DavidMFlynn/Rocket-Servo/README.md

# Rocket-Servo
 Altimeter triggered 2 position servo driver
