DavidMFlynn/Rocket-Servo/PCB RS2 Rev nc/Fixture/Fixture.3mf

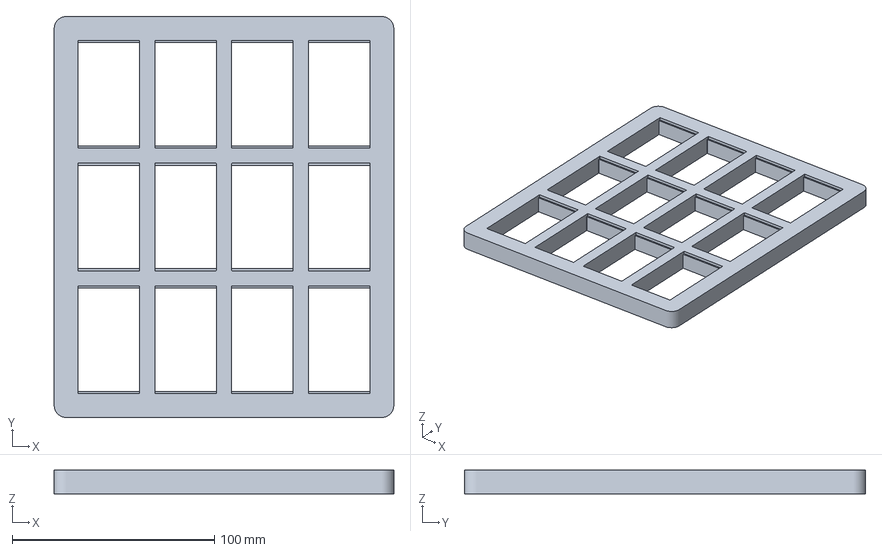
[picture p1: CAD file, 2025-12-25]
PCB RS2 Rev nc/Fixture/Fixture.3mf
168.0 x 198.4 x 11.7 mm
