DavidMFlynn/Rocket-Servo/RS2_PCBA_Fixture.3mf

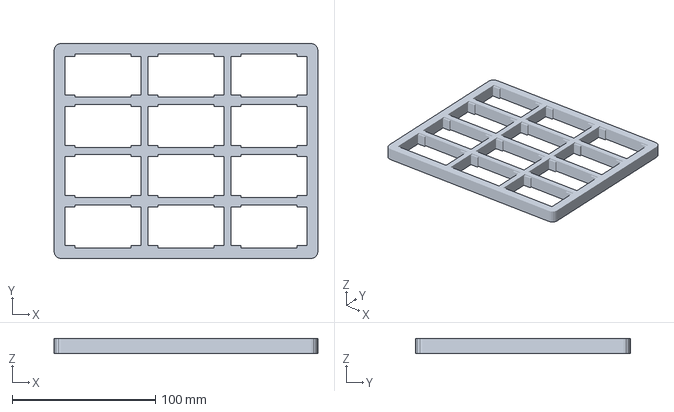
[picture p2: CAD file, 2026-05-11]
RS2_PCBA_Fixture.3mf
184.0 x 150.0 x 10.5 mm
