DavidMFlynn/Rocket-Servo/RS_PCBA_Fixture.3mf

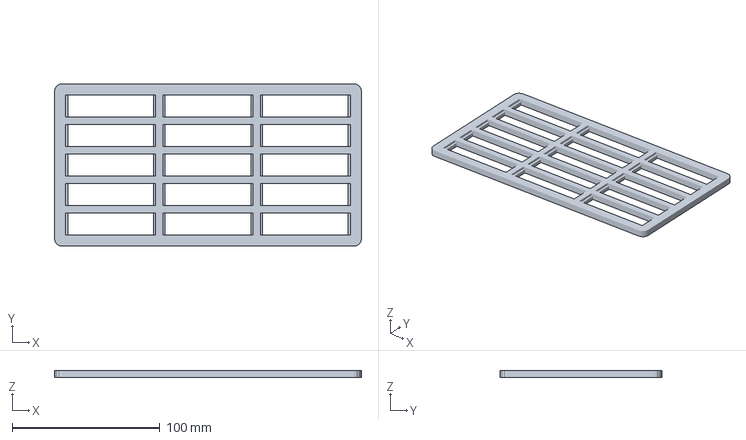
[picture p3: CAD file, 2024-05-13]
RS_PCBA_Fixture.3mf
208.0 x 110.0 x 5.00 mm
