DavidMFlynn/Rocket-Servo/(list of files, cad)

Other CAD files:
PCB RS2 Rev nc/Fixture/Fixture.stl
RS2_PCBA_Fixture.stl
RS_PCBA_Fixture.stl
