DavidMFlynn/Rocket-Servo/PCB Rev C/RocketServo.sch.pdf

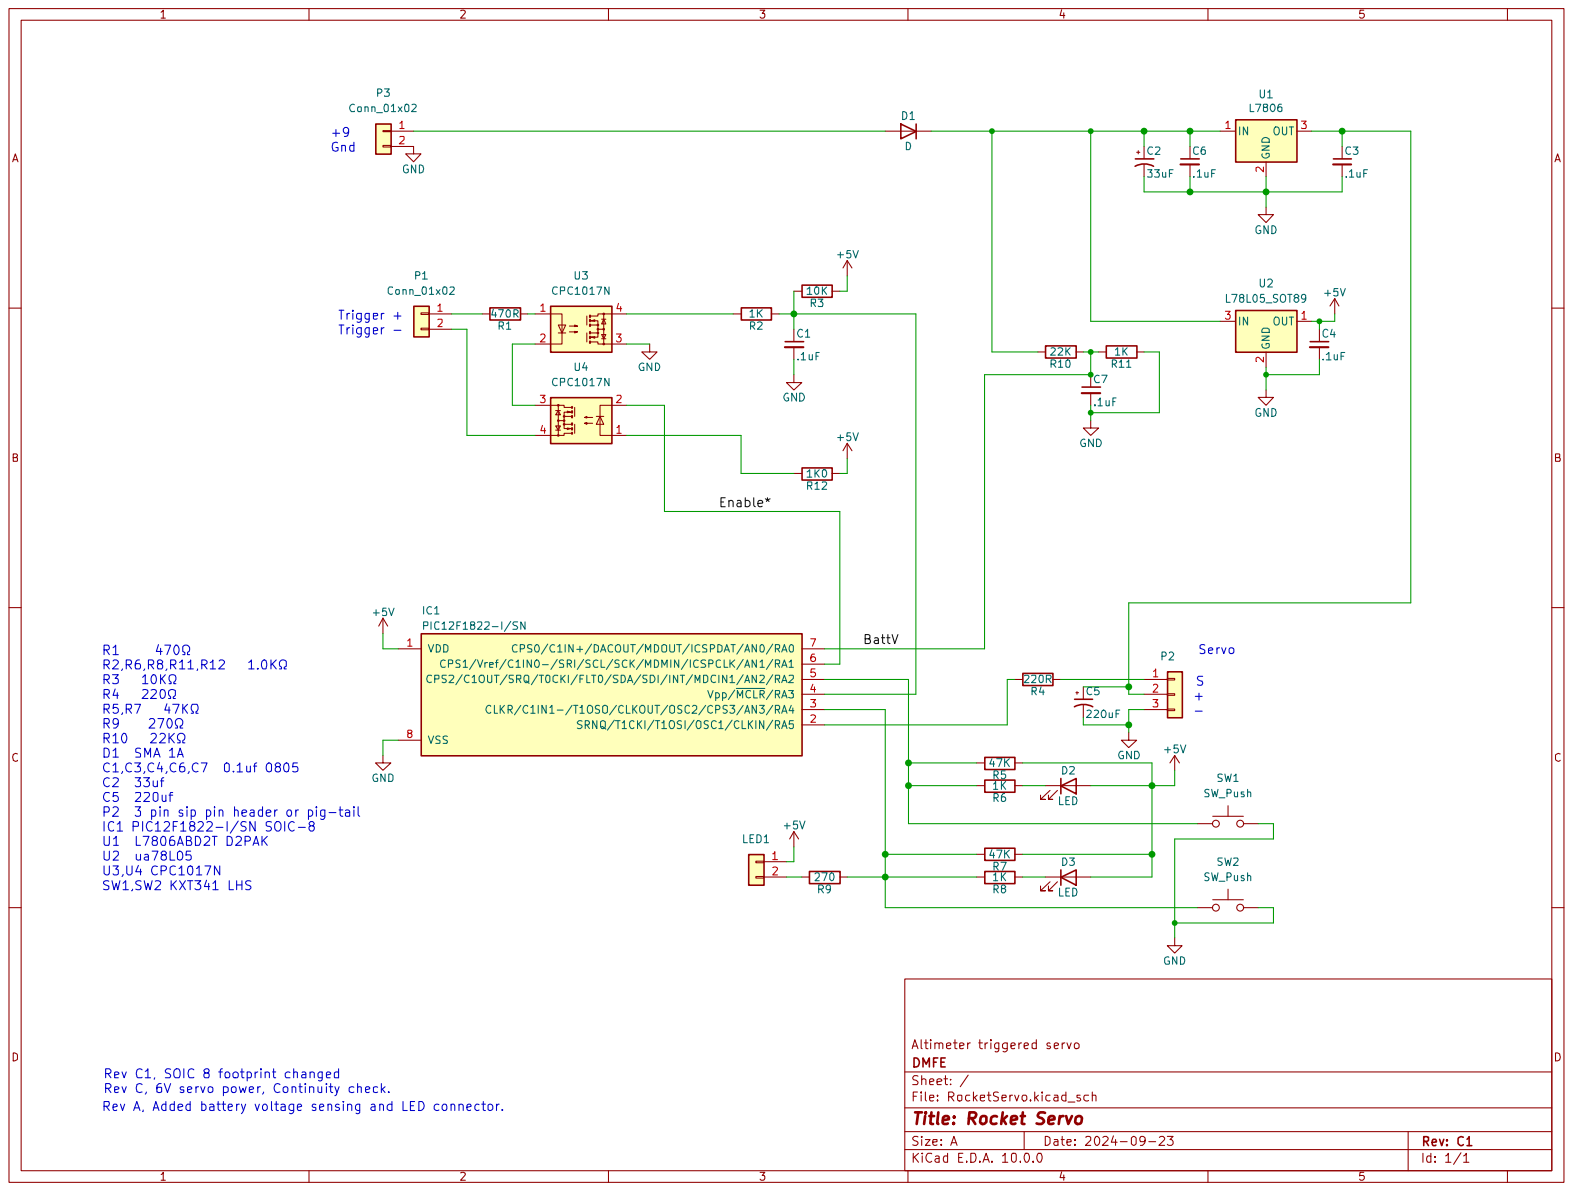
[picture p4: page 1]
