DavidMFlynn/Rocket-Servo/PCB RS2 Rev nc/RocketServo.kicad_sch.pdf

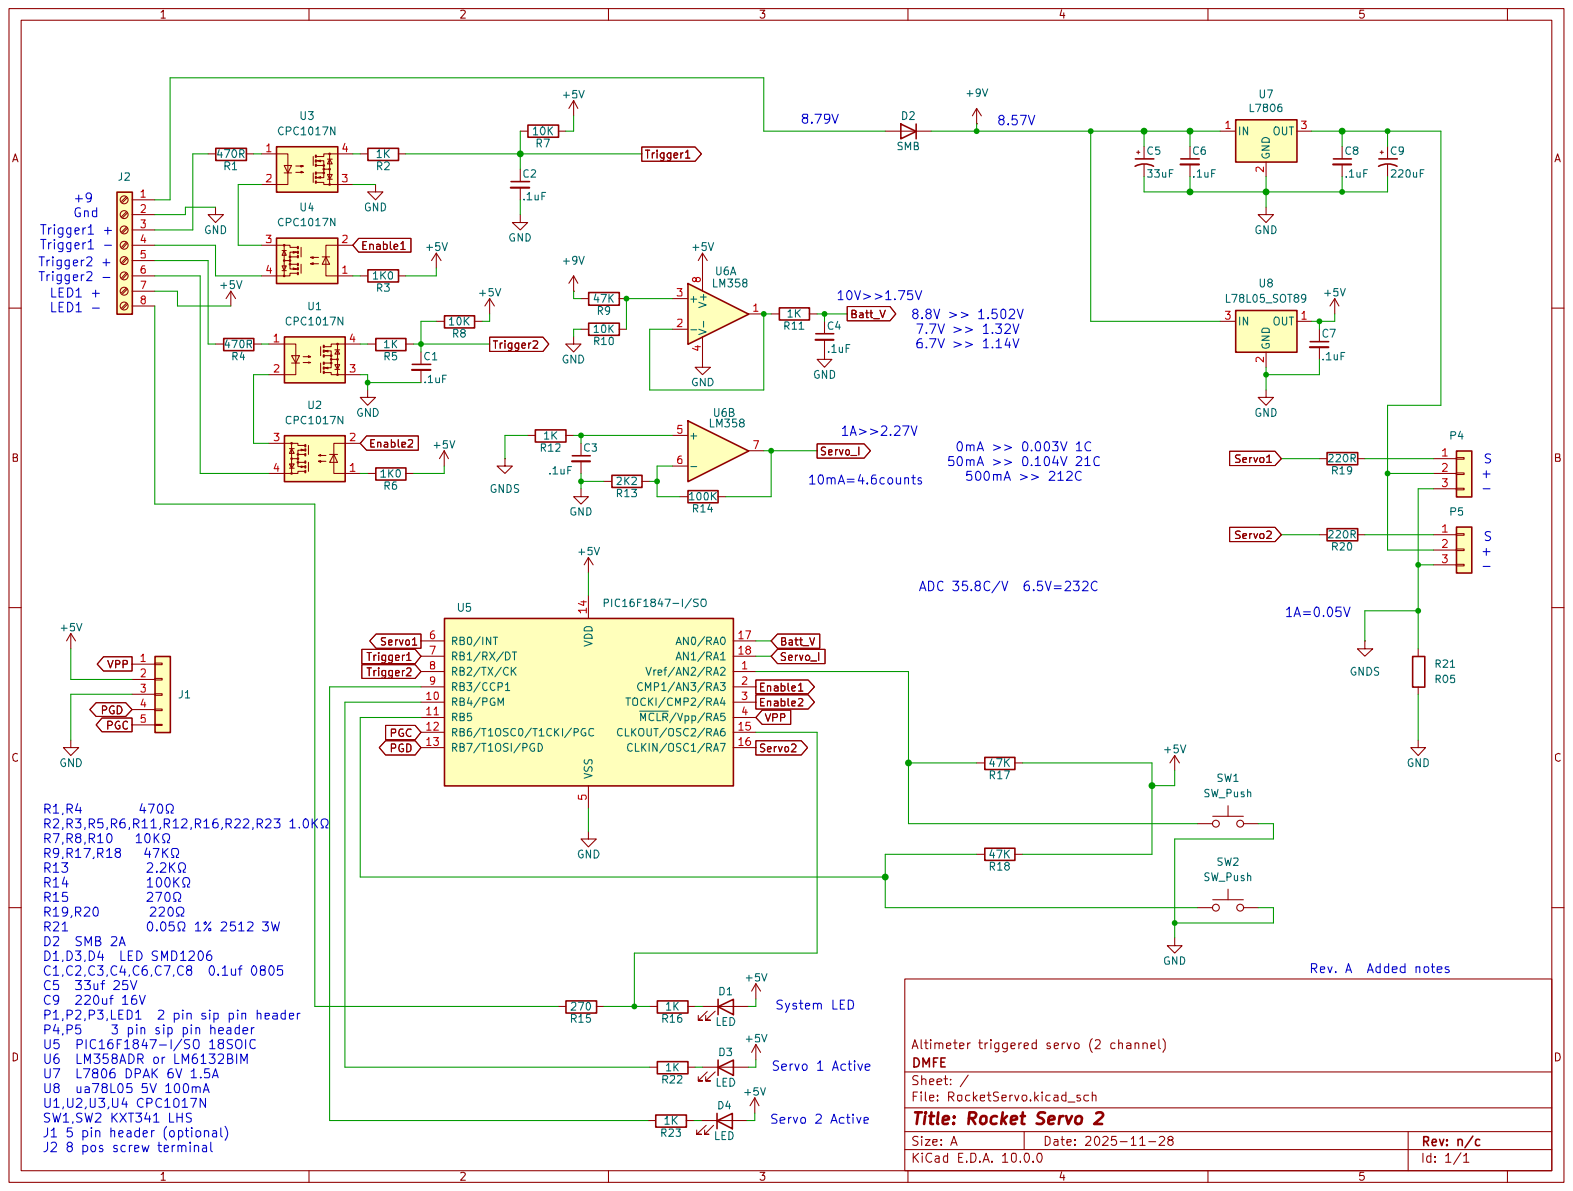
[picture p5: page 1]
