DavidMFlynn/Rocket-Servo/PCB Rev B/RocketServoRevA.sch.pdf

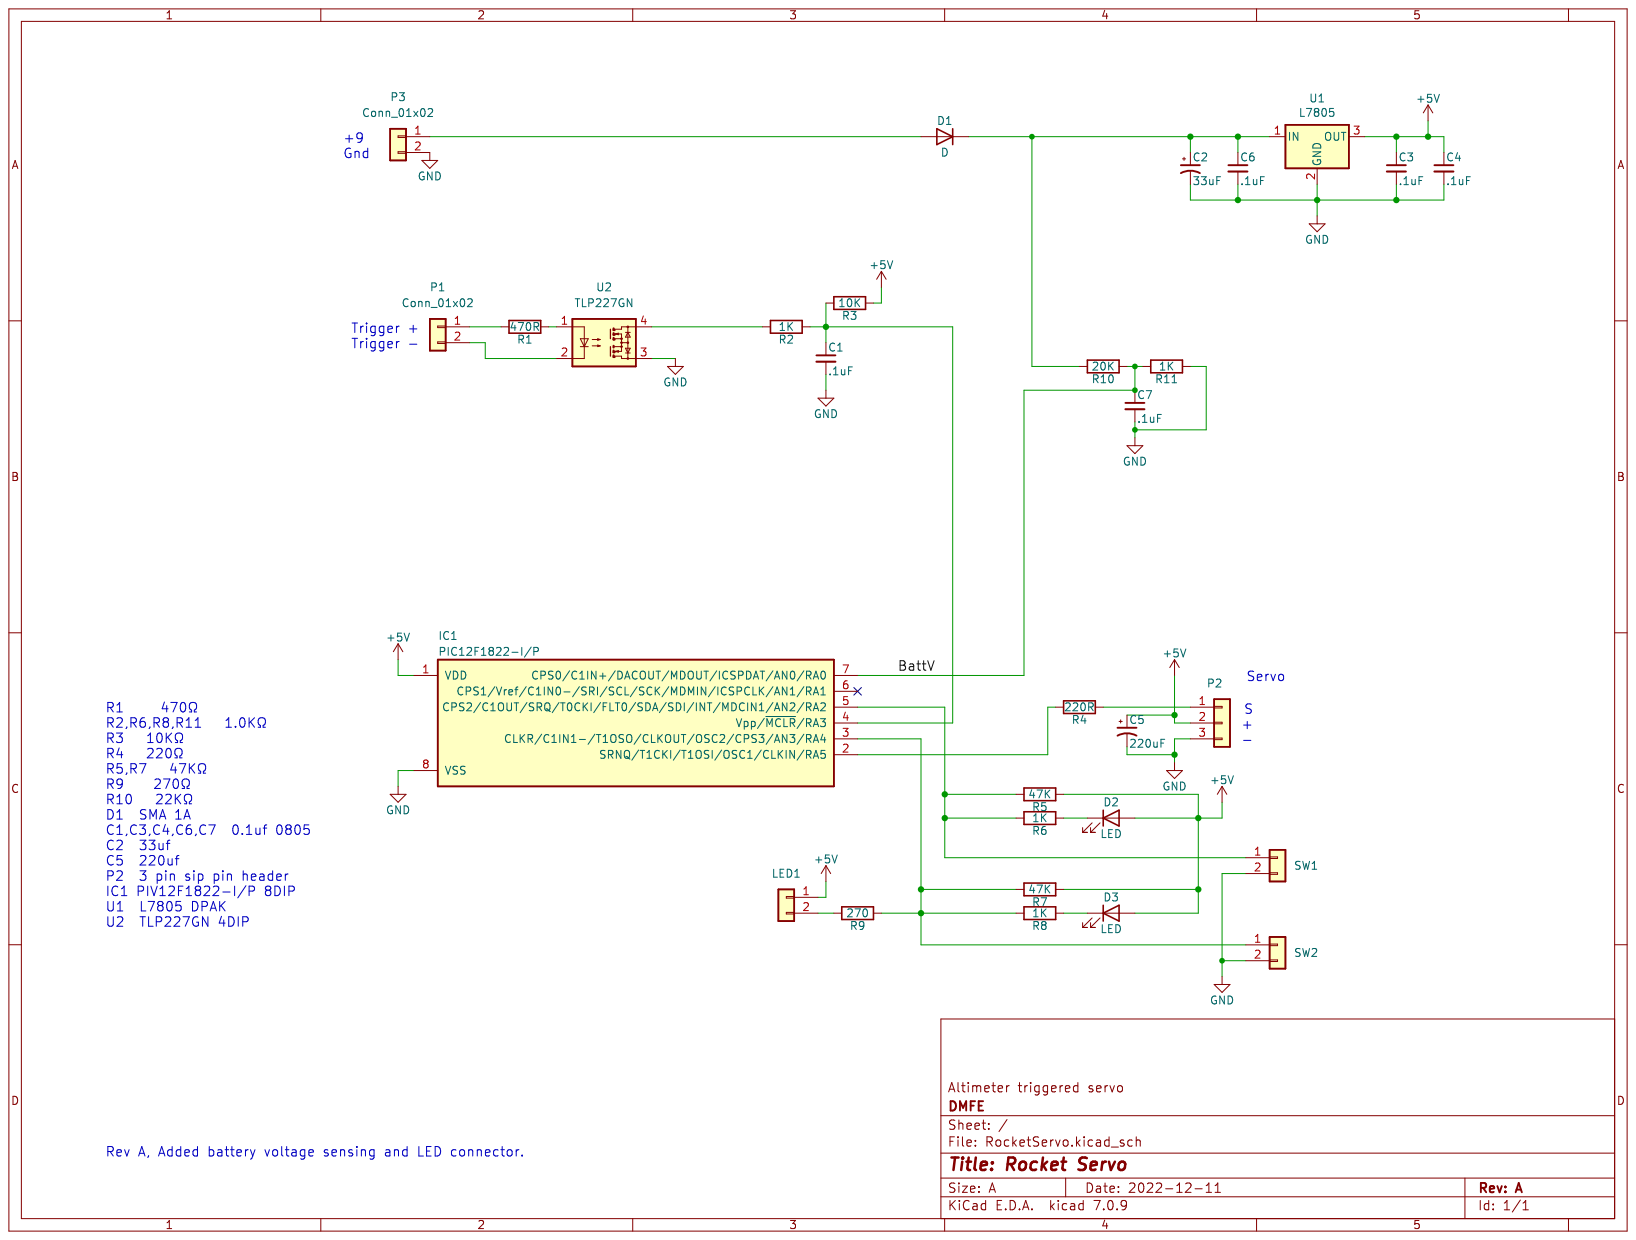
[picture p6: page 1]
