DavidMFlynn/Rocket-Servo/PCB Rev B/B.Fab.pdf

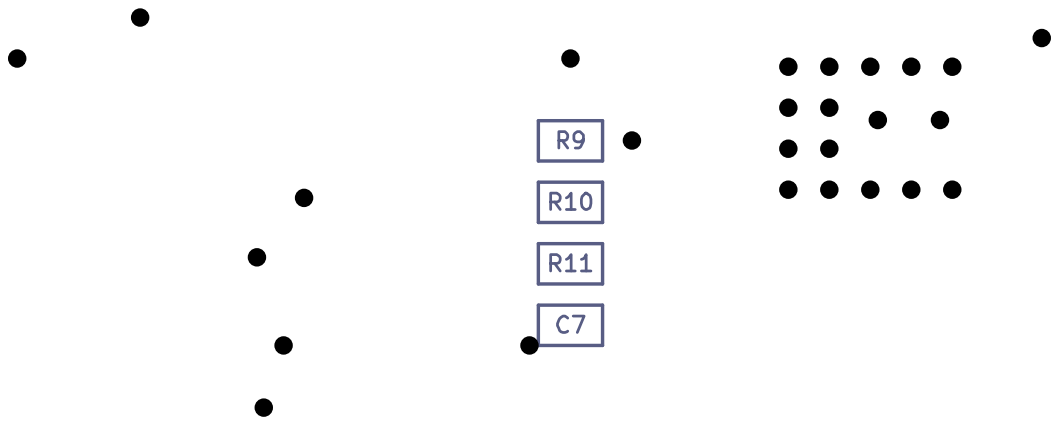
[picture p7: page 1]
