DavidMFlynn/Rocket-Servo/PCB Rev B/F.Fab.pdf

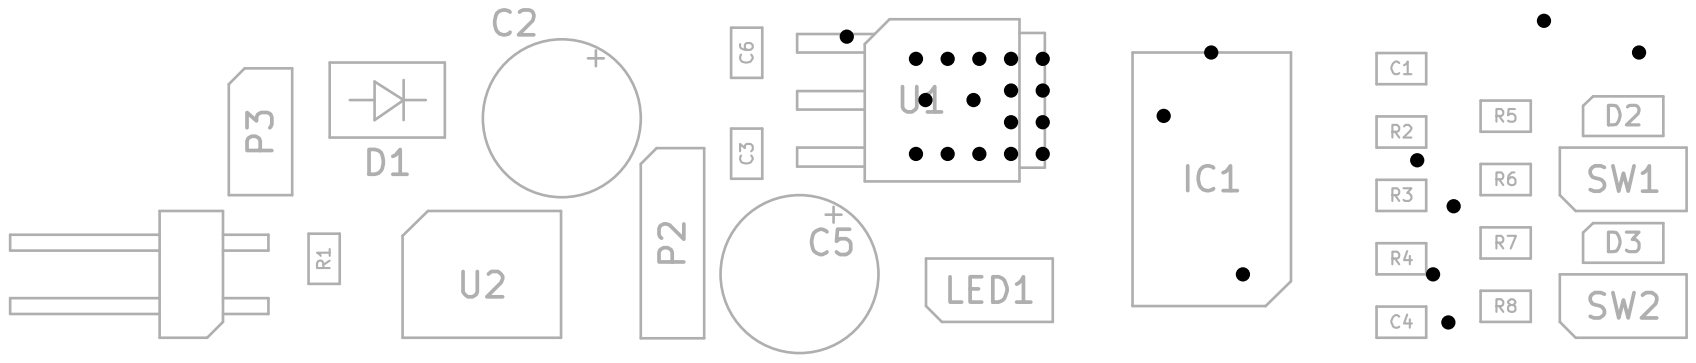
[picture p8: page 1]
