DavidMFlynn/Rocket-Servo/PCB Rev A/RCSMCtrl.sch.pdf

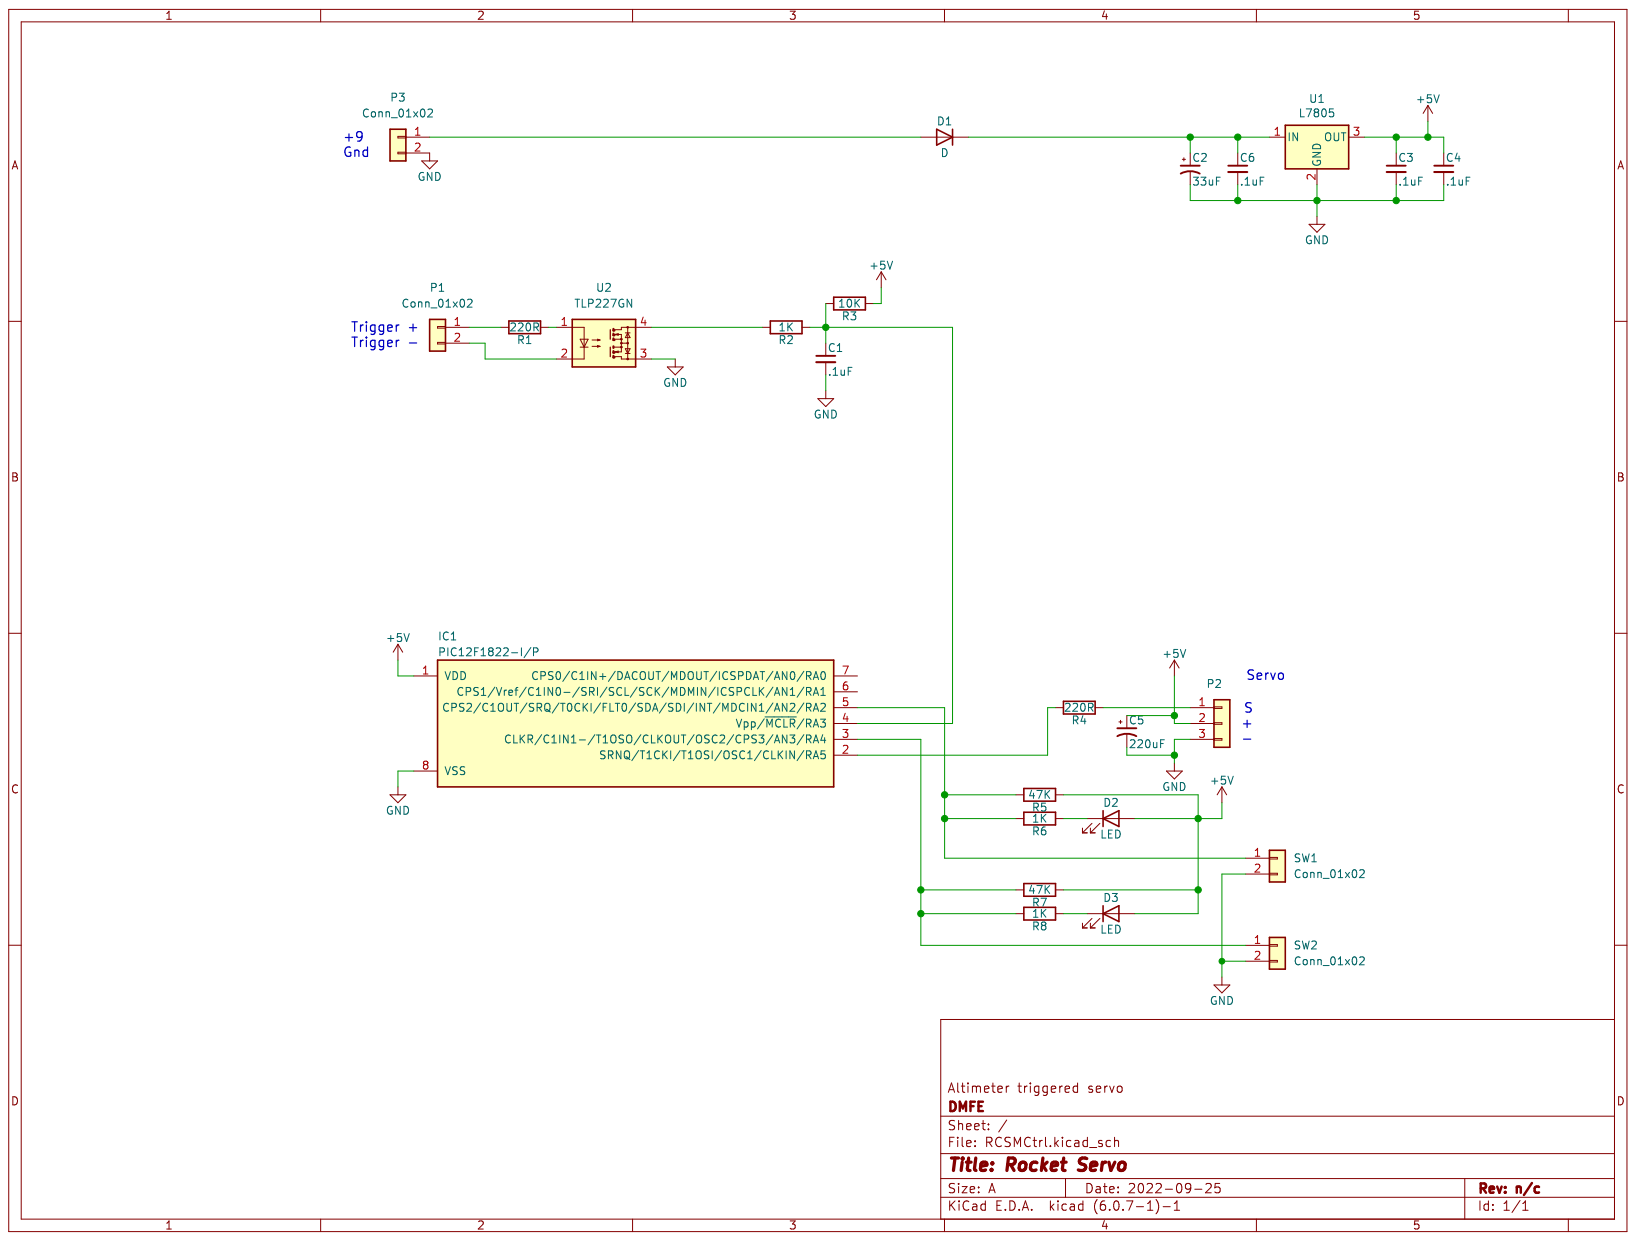
[picture p9: page 1]
