DavidMFlynn/Rocket-Servo/PCB RS2 Rev nc/RocketServo.kicad_pcb

## KiCad design PCB RS2 Rev nc/RocketServo.kicad_pcb (2026-04-16)

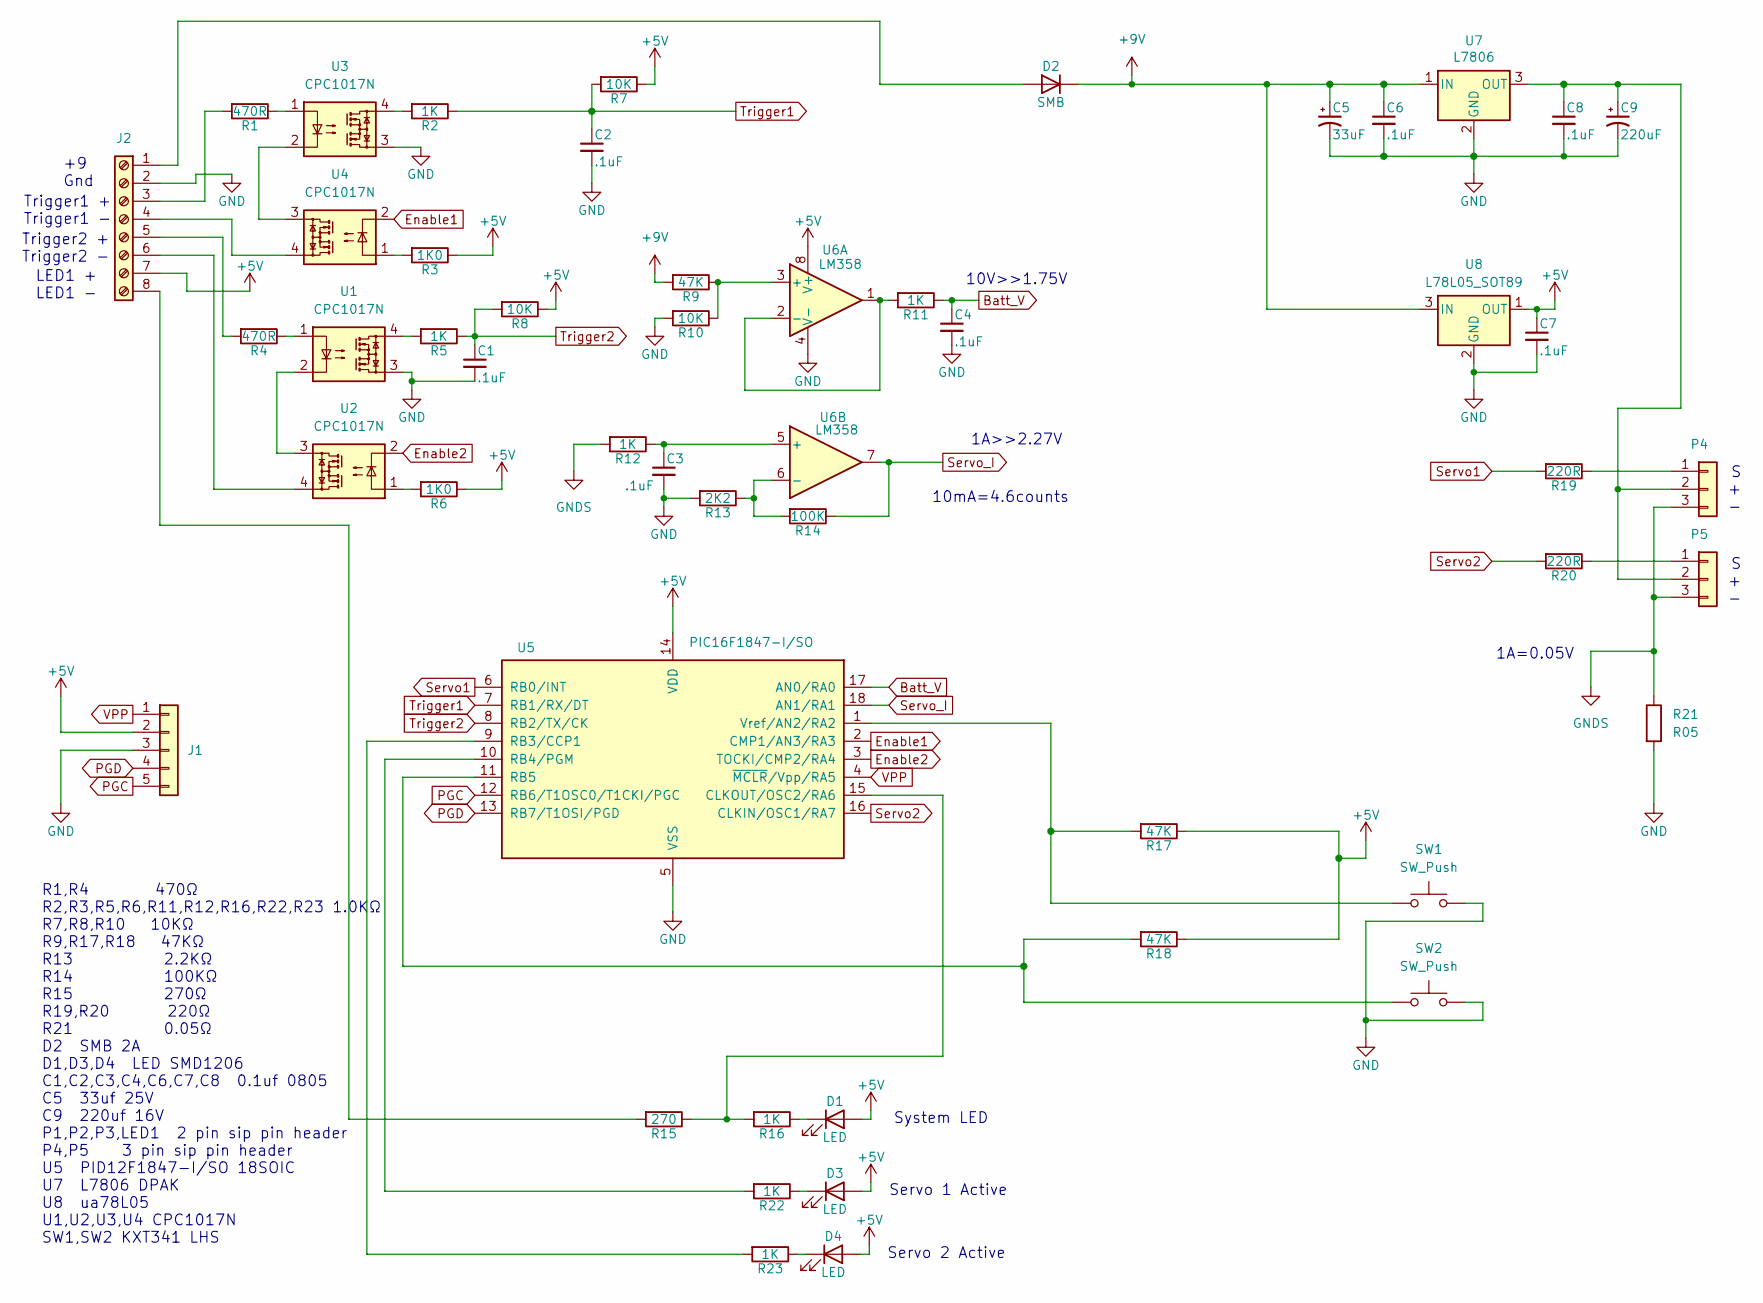
[picture p10: schematic RocketServo.kicad_sch, Rocket Servo 2]

Parts:
C1, C2, C3, C4, C6, C7, C8: .1uF; C_0805_2012Metric_Pad1.18x1.45mm_HandSolder
C5: 33uF; CP_Radial_D5.0mm_P2.00mm
C9: 220uF; CP_Radial_D6.3mm_P2.50mm
D1, D3, D4: LED; LED_1206_3216Metric_Pad1.42x1.75mm_HandSolder
D2: SMB; D_SMA
J1: Conn_01x05; PinHeader_1x05_P2.54mm_Vertical
J2: Screw_Terminal_01x08; TerminalBlock_Xinya_XY308-2.54-8P_1x08_P2.54mm_Horizontal
P4, P5: Conn_01x03; PinHeader_1x03_P2.54mm_Vertical
R1, R4: 470R; R_0805_2012Metric_Pad1.20x1.40mm_HandSolder
R2, R5, R11, R12, R16, R22, R23: 1K; R_0805_2012Metric_Pad1.20x1.40mm_HandSolder
R3, R6: 1K0; R_0805_2012Metric_Pad1.20x1.40mm_HandSolder
R7, R8, R10: 10K; R_0805_2012Metric_Pad1.20x1.40mm_HandSolder
R9, R17, R18: 47K; R_0805_2012Metric_Pad1.20x1.40mm_HandSolder
R13: 2K2; R_0805_2012Metric_Pad1.20x1.40mm_HandSolder
R14: 100K; R_0805_2012Metric_Pad1.20x1.40mm_HandSolder
R15: 270; R_0805_2012Metric_Pad1.20x1.40mm_HandSolder
R19, R20: 220R; R_0805_2012Metric_Pad1.20x1.40mm_HandSolder
R21: R05; R_2512_6332Metric_Pad1.40x3.35mm_HandSolder
SW1, SW2: SW_Push; R_1206_3216Metric
U1, U2, U3, U4: CPC1017N; SOP-4_3.8x4.1mm_P2.54mm
U5: PIC16F1847-I/SO; SOIC-18W_7.5x11.6mm_P1.27mm
U6: LM358; SOIC-8_3.9x4.9mm_P1.27mm
U7: L7806; TO-263-2
U8: L78L05_SOT89; SOT-89-3

Connections:
+5V: C7.1, D1.2 (A), D3.2 (A), D4.2 (A), J1.2, J2.7, R3.1, R6.1, R7.1, R8.1, R17.1, R18.1, U5.14 (VDD), U6.8 (V+), U8.1 (OUT)
+9V: C5.1, C6.1, D2.1 (K), R9.2, U7.1 (IN), U8.3 (IN)
Batt_V: C4.1, R11.1, U5.17 (AN0/RA0)
Enable1: U4.2, U5.2 (CMP1/AN3/RA3)
Enable2: U2.2, U5.3 (TOCKI/CMP2/RA4)
GND: C1.2, C2.2, C3.2, C4.2, C5.2, C6.2, C7.2, C8.2, C9.2, J1.3, J2.2, R10.2, R13.2, R21.2, SW1.2, SW2.2, U1.3, U3.3, U5.5 (VSS), U6.4 (V-), U7.2 (GND), U8.2 (GND)
GNDS: P4.3, P5.3, R12.2, R21.1
unnamed: D1.1 (K), R16.1
unnamed: D2.2 (A), J2.1
unnamed: D3.1 (K), R22.1
unnamed: D4.1 (K), R23.1
unnamed: J2.3, R1.2
unnamed: J2.4, U4.4
unnamed: J2.5, R4.2
unnamed: J2.6, U2.4
unnamed: J2.8, R15.2
unnamed: P4.1, R19.1
unnamed: C8.1, C9.1, P4.2, P5.2, U7.3 (OUT)
unnamed: P5.1, R20.1
unnamed: R1.1, U3.1
unnamed: R2.2, U3.4
unnamed: R3.2, U4.1
unnamed: R4.1, U1.1
unnamed: R5.2, U1.4
unnamed: R6.2, U2.1
unnamed: U1.2, U2.3
unnamed: U3.2, U4.3
unnamed: R15.1, R16.2, U5.15 (CLKOUT/OSC2/RA6)
unnamed: R23.2, U5.9 (RB3/CCP1)
unnamed: R22.2, U5.10 (RB4/PGM)
unnamed: R18.2, SW2.1, U5.11 (RB5)
unnamed: R17.2, SW1.1, U5.1 (Vref/AN2/RA2)
unnamed: R9.1, R10.1, U6.3 (+)
unnamed: R11.2, U6.1, U6.2 (-)
unnamed: C3.1, R12.1, U6.5 (+)
unnamed: R13.1, R14.2, U6.6 (-)
PGC: J1.5, U5.12 (RB6/T1OSC0/T1CKI/PGC)
PGD: J1.4, U5.13 (RB7/T1OSI/PGD)
Servo1: R19.2, U5.6 (RB0/INT)
Servo2: R20.2, U5.16 (CLKIN/OSC1/RA7)
Servo_I: R14.1, U5.18 (AN1/RA1), U6.7
Trigger1: C2.1, R2.1, R7.2, U5.7 (RB1/RX/DT)
Trigger2: C1.1, R5.1, R8.2, U5.8 (RB2/TX/CK)
VPP: J1.1, U5.4 (~MCLR/Vpp/RA5)

Notes on the sheet:
+9 Gnd
R1,R4 470Ω R2,R3,R5,R6,R11,R12,R16,R22,R23 1.0KΩ R7,R8,R10 10KΩ R9,R17,R18 47KΩ R13 2.2KΩ R14 100KΩ R15 270Ω R19,R20 220Ω R21 0.05Ω D2 SMB 2A D1,D3,D4 LED SMD1206 C1,C2,C3,C4,C6,C7,C8 0.1uf 0805 C5 33uf 25V C9 220uf 16V P1,P2,P3,LED1 2 pin sip pin header P4,P5 3 pin sip pin header U5 PID12F1847-I/S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
S + -
1A>>2.27V
Servo 2 Active
1A=0.05V
10V>>1.75V
LED1 + LED1 -
Trigger1 + Trigger1 -
Servo 1 Active
10mA=4.6counts
System LED
Trigger2 + Trigger2 -

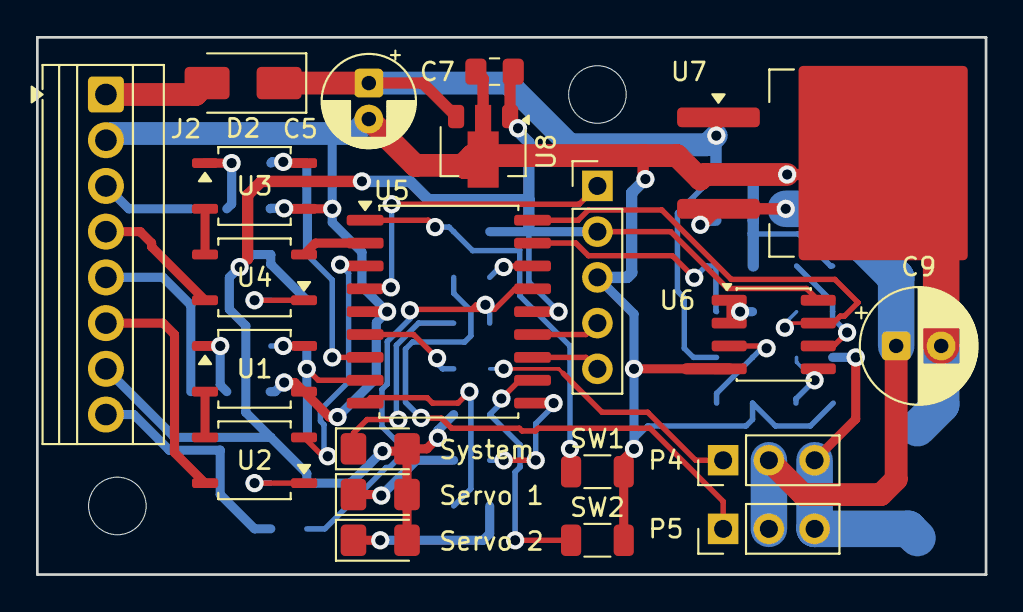
[picture p11: board PCB RS2 Rev nc/RocketServo.kicad_pcb from above]

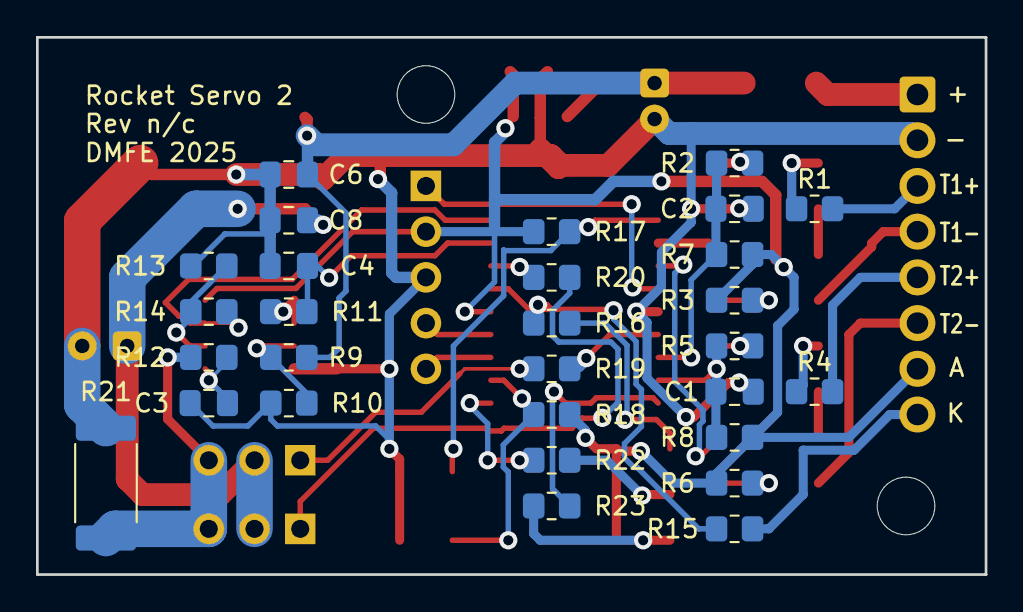
[picture p12: board PCB RS2 Rev nc/RocketServo.kicad_pcb from below]

Board: 2 copper layers, 52.7 x 29.8 mm, 52 parts (29 on the bottom side), 44 nets.

Other parts of the board:
H1, H2: MountingHole_3.2mm_M3
