DavidMFlynn/Rocket-Servo/PCB RS4 Rev nc/RocketServo.kicad_pcb

## KiCad design PCB RS4 Rev nc/RocketServo.kicad_pcb (2025-12-02)

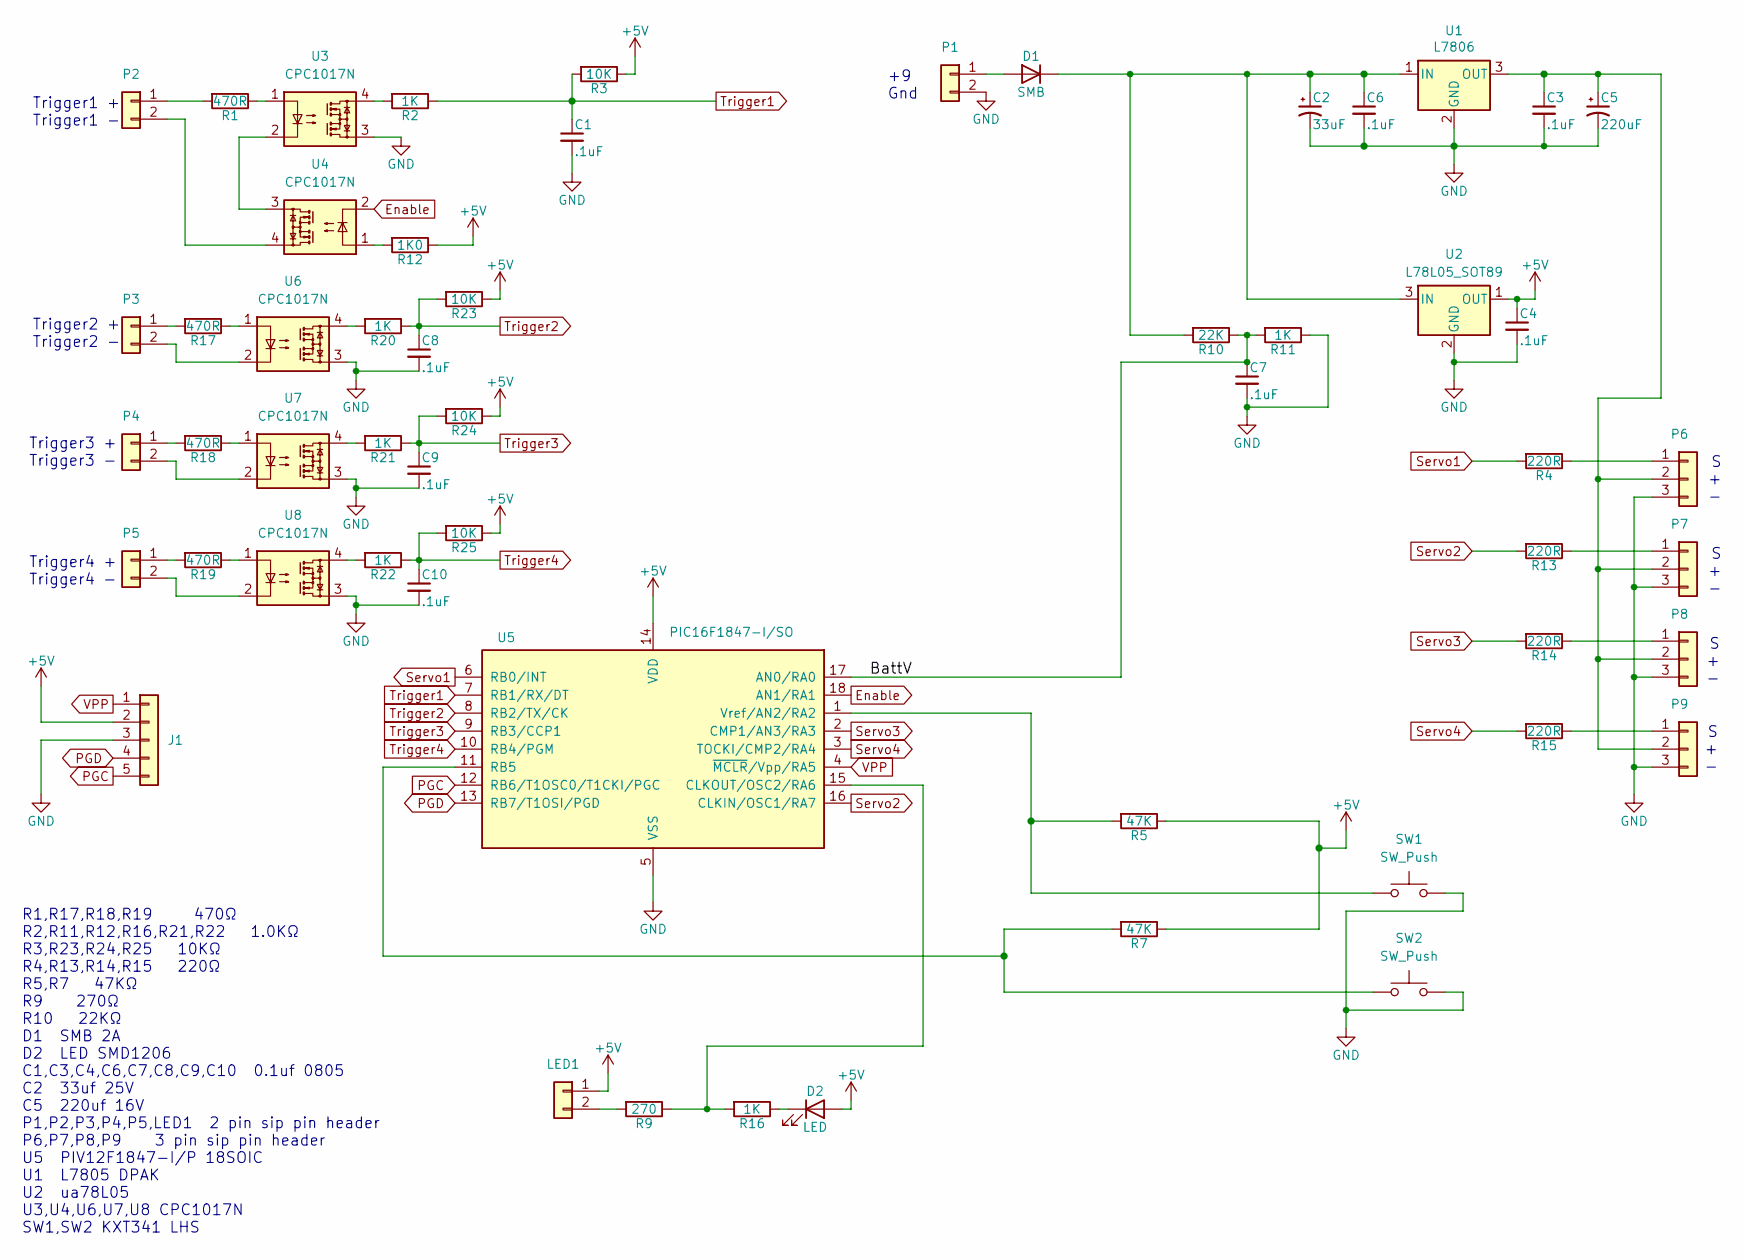
[picture p13: schematic RocketServo.kicad_sch, Rocket Servo 4]

Parts:
C1, C3, C4, C6, C7, C8, C9, C10: .1uF; C_0805_2012Metric_Pad1.18x1.45mm_HandSolder
C2: 33uF; CP_Radial_D5.0mm_P2.00mm
C5: 220uF; CP_Radial_D6.3mm_P2.50mm
D1: SMB; D_SMA
D2: LED; LED_1206_3216Metric_Pad1.42x1.75mm_HandSolder
J1: Conn_01x05; PinHeader_1x05_P2.54mm_Vertical
LED1: Conn_01x02; PinHeader_1x02_P2.54mm_Vertical
P1, P2, P3, P4, P5: Conn_01x02; PinHeader_1x02_P2.54mm_Vertical
P6, P7, P8, P9: Conn_01x03; PinHeader_1x03_P2.54mm_Vertical
R1, R17, R18, R19: 470R; R_0805_2012Metric_Pad1.20x1.40mm_HandSolder
R2, R11, R16, R20, R21, R22: 1K; R_0805_2012Metric_Pad1.20x1.40mm_HandSolder
R3, R23, R24, R25: 10K; R_0805_2012Metric_Pad1.20x1.40mm_HandSolder
R4, R13, R14, R15: 220R; R_0805_2012Metric_Pad1.20x1.40mm_HandSolder
R5, R7: 47K; R_0805_2012Metric_Pad1.20x1.40mm_HandSolder
R9: 270; R_0805_2012Metric_Pad1.20x1.40mm_HandSolder
R10: 22K; R_0805_2012Metric_Pad1.20x1.40mm_HandSolder
R12: 1K0; R_0805_2012Metric_Pad1.20x1.40mm_HandSolder
SW1, SW2: SW_Push; R_1206_3216Metric
U1: L7806; TO-263-2
U2: L78L05_SOT89; SOT-89-3
U3, U4, U6, U7, U8: CPC1017N; SOP-4_3.8x4.1mm_P2.54mm
U5: PIC16F1847-I/SO; SOIC-18W_7.5x11.6mm_P1.27mm

Connections:
+5V: C4.1, D2.2 (A), J1.2, LED1.1, R3.1, R5.1, R7.1, R12.1, R23.1, R24.1, R25.1, U2.1 (OUT), U5.14 (VDD)
/BattV: C7.1, R10.1, R11.2, U5.17 (AN0/RA0)
Enable: U4.2, U5.18 (AN1/RA1)
GND: C1.2, C2.2, C3.2, C4.2, C5.2, C6.2, C7.2, C8.2, C9.2, C10.2, J1.3, P1.2, P6.3, P7.3, P8.3, P9.3, R11.1, SW1.2, SW2.2, U1.2 (GND), U2.2 (GND), U3.3, U5.5 (VSS), U6.3, U7.3, U8.3
unnamed: D1.2 (A), P1.1
unnamed: C2.1, C6.1, D1.1 (K), R10.2, U1.1 (IN), U2.3 (IN)
unnamed: D2.1 (K), R16.1
unnamed: LED1.2, R9.2
unnamed: P2.1, R1.2
unnamed: P2.2, U4.4
unnamed: P3.1, R17.2
unnamed: P3.2, U6.2
unnamed: P4.1, R18.2
unnamed: P4.2, U7.2
unnamed: P5.1, R19.2
unnamed: P5.2, U8.2
unnamed: P6.1, R4.1
unnamed: C3.1, C5.1, P6.2, P7.2, P8.2, P9.2, U1.3 (OUT)
unnamed: P7.1, R13.1
unnamed: P8.1, R14.1
unnamed: P9.1, R15.1
unnamed: R1.1, U3.1
unnamed: R2.2, U3.4
unnamed: R12.2, U4.1
unnamed: R17.1, U6.1
unnamed: R18.1, U7.1
unnamed: R19.1, U8.1
unnamed: R20.2, U6.4
unnamed: R21.2, U7.4
unnamed: R22.2, U8.4
unnamed: U3.2, U4.3
unnamed: R9.1, R16.2, U5.15 (CLKOUT/OSC2/RA6)
unnamed: R7.2, SW2.1, U5.11 (RB5)
unnamed: R5.2, SW1.1, U5.1 (Vref/AN2/RA2)
PGC: J1.5, U5.12 (RB6/T1OSC0/T1CKI/PGC)
PGD: J1.4, U5.13 (RB7/T1OSI/PGD)
Servo1: R4.2, U5.6 (RB0/INT)
Servo2: R13.2, U5.16 (CLKIN/OSC1/RA7)
Servo3: R14.2, U5.2 (CMP1/AN3/RA3)
Servo4: R15.2, U5.3 (TOCKI/CMP2/RA4)
Trigger1: C1.1, R2.1, R3.2, U5.7 (RB1/RX/DT)
Trigger2: C8.1, R20.1, R23.2, U5.8 (RB2/TX/CK)
Trigger3: C9.1, R21.1, R24.2, U5.9 (RB3/CCP1)
Trigger4: C10.1, R22.1, R25.2, U5.10 (RB4/PGM)
VPP: J1.1, U5.4 (~MCLR/Vpp/RA5)

Notes on the sheet:
+9 Gnd
Trigger3 + Trigger3 -
R1,R17,R18,R19 470Ω R2,R11,R12,R16,R21,R22 1.0KΩ R3,R23,R24,R25 10KΩ R4,R13,R14,R15 220Ω R5,R7 47KΩ R9 270Ω R10 22KΩ D1 SMB 2A D2 LED SMD1206 C1,C3,C4,C6,C7,C8,C9,C10 0.1uf 0805 C2 33uf 25V C5 220uf 16V P1,P2,P3,P4,P5,LED1 2 pin sip pin header P6,P7,P8,P9 3 pin sip pin header U5 PIV12F1847-I/P 18SO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
S + -
Trigger4 + Trigger4 -
Trigger1 + Trigger1 -
Trigger2 + Trigger2 -

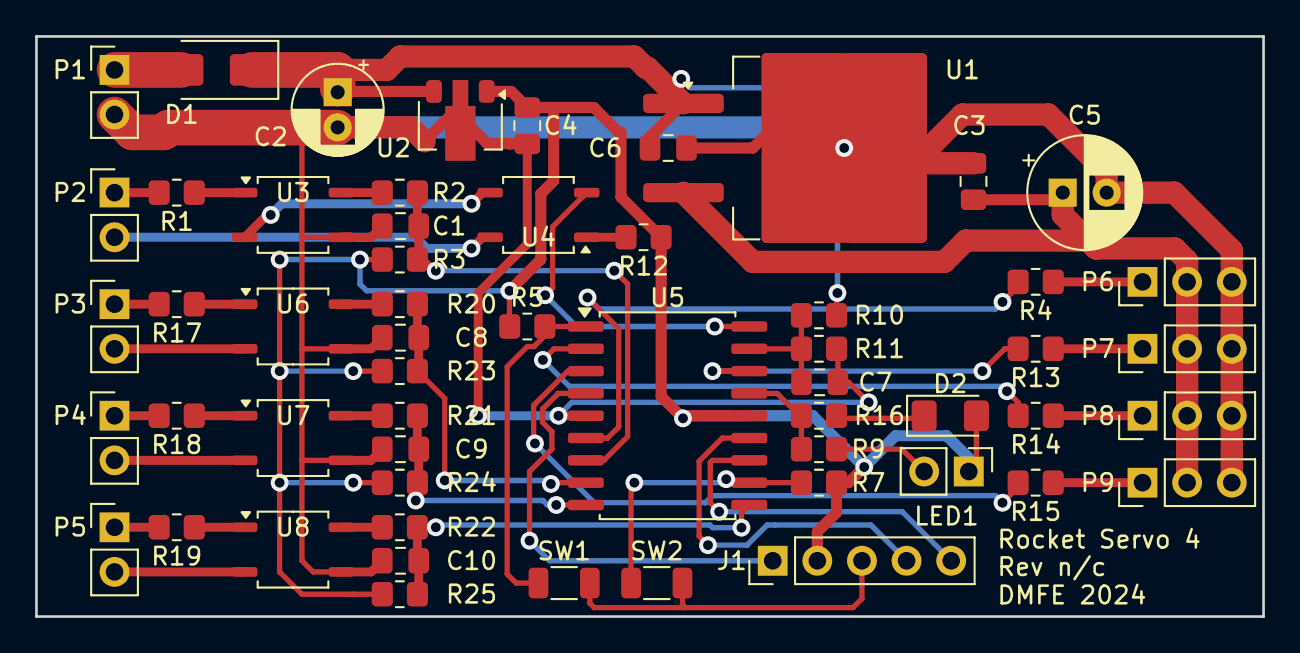
[picture p14: board PCB RS4 Rev nc/RocketServo.kicad_pcb from above]

Board: 2 copper layers, 69.9 x 33.0 mm, 56 parts (0 on the bottom side), 45 nets.
