DavidMFlynn/Rocket-Servo/RotarySW/RotarySW.kicad_pcb

## KiCad design RotarySW/RotarySW.kicad_pcb (2025-02-19)

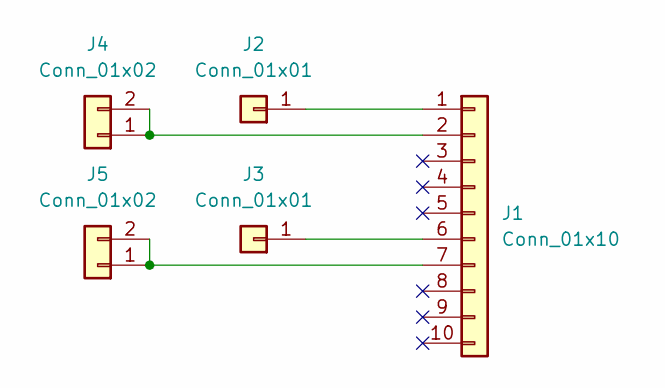
[picture p15: schematic RotarySW.kicad_sch, Rotary Switch]

Parts:
J1: Conn_01x10; Rotary2x5
J2, J3: Conn_01x01; PinHeader_1x01_P2.54mm_Vertical
J4, J5: Conn_01x02; PinHeader_1x02_P2.54mm_Vertical

Connections:
unnamed: J1.1, J2.1
unnamed: J1.2, J4.1, J4.2
unnamed: J1.6, J3.1
unnamed: J1.7, J5.1, J5.2

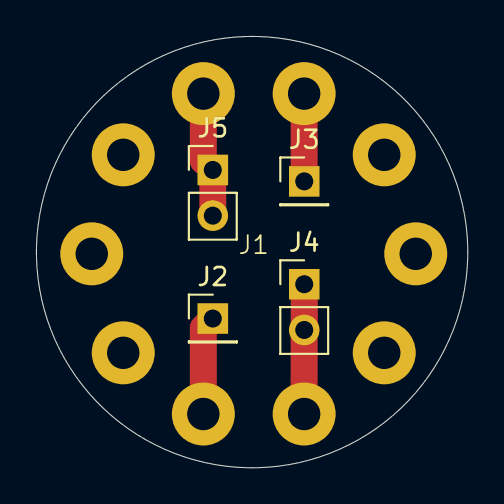
[picture p16: board RotarySW.kicad_pcb from above]

Board: 2 copper layers, 24.0 x 24.0 mm, 5 parts (0 on the bottom side), 4 nets.
