DavidMFlynn/Rocket-Servo/PCB Rev C/RocketServo.kicad_pcb

## KiCad design PCB Rev C/RocketServo.kicad_pcb (2024-10-18)

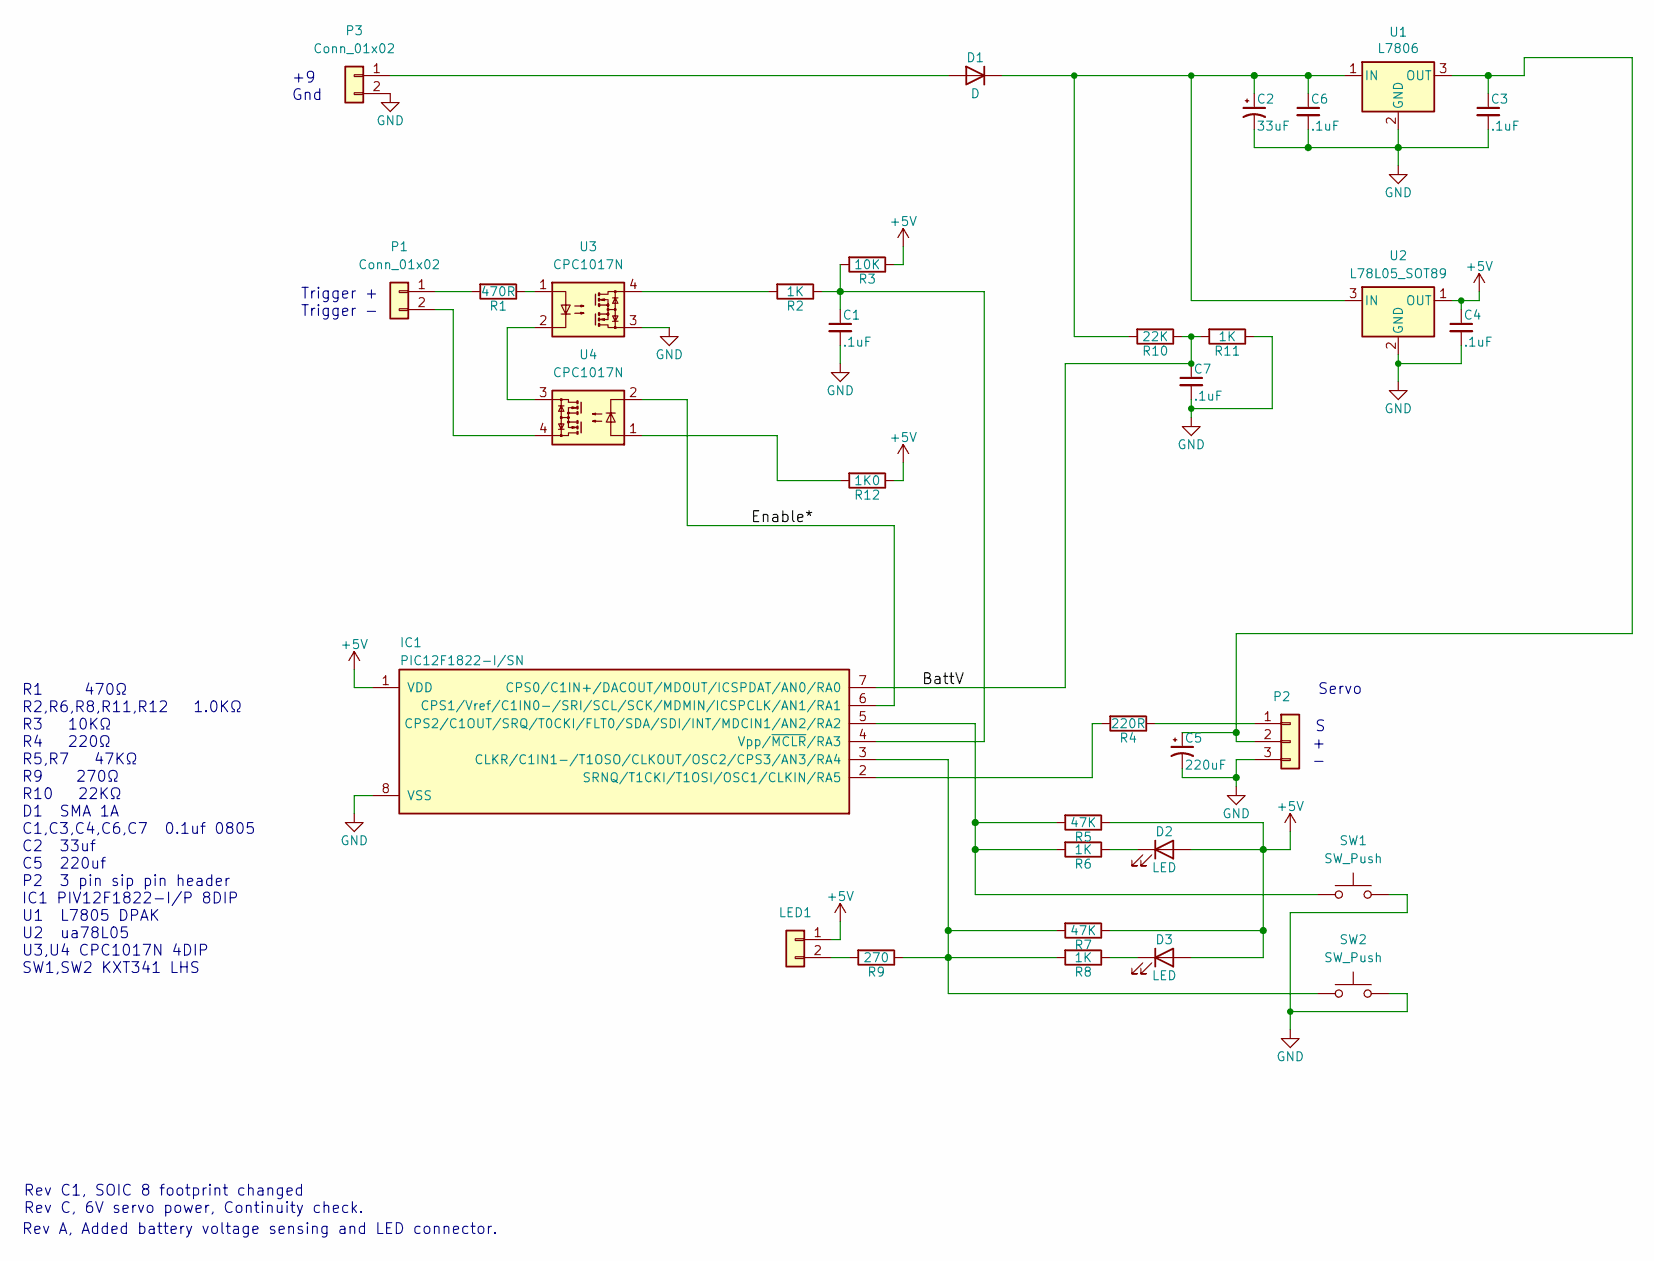
[picture p17: schematic RocketServo.kicad_sch, Rocket Servo]

Parts:
C1, C3, C4, C6, C7: .1uF; C_0805_2012Metric_Pad1.18x1.45mm_HandSolder
C2: 33uF; CP_Radial_D5.0mm_P2.00mm
C5: 220uF; CP_Radial_D6.3mm_P2.50mm
D1: D; D_SMA
D2, D3: LED; LED_1206_3216Metric_Pad1.42x1.75mm_HandSolder
IC1: PIC12F1822-I/SN; SOIC-8_3.9x4.9mm_P1.27mm
LED1: Conn_01x02; PinHeader_1x02_P2.54mm_Vertical
P1, P3: Conn_01x02; PinHeader_1x02_P2.54mm_Vertical
P2: Conn_01x03; PinHeader_1x03_P2.54mm_Vertical
R1: 470R; R_0805_2012Metric_Pad1.20x1.40mm_HandSolder
R2, R6, R8, R11: 1K; R_0805_2012Metric_Pad1.20x1.40mm_HandSolder
R3: 10K; R_0805_2012Metric_Pad1.20x1.40mm_HandSolder
R4: 220R; R_0805_2012Metric_Pad1.20x1.40mm_HandSolder
R5, R7: 47K; R_0805_2012Metric_Pad1.20x1.40mm_HandSolder
R9: 270; R_0805_2012Metric_Pad1.20x1.40mm_HandSolder
R10: 22K; R_0805_2012Metric_Pad1.20x1.40mm_HandSolder
R12: 1K0; R_0805_2012Metric_Pad1.20x1.40mm_HandSolder
SW1, SW2: SW_Push; R_1206_3216Metric
U1: L7806; TO-263-2
U2: L78L05_SOT89; SOT-89-3
U3, U4: CPC1017N; SOP-4_3.8x4.1mm_P2.54mm

Connections:
+5V: C4.1, D2.2 (A), D3.2 (A), IC1.1 (VDD), LED1.1, R3.1, R5.1, R7.1, R12.1, U2.1 (OUT)
/BattV: C7.1, IC1.7 (CPS0/C1IN+/DACOUT/MDOUT/ICSPDAT/AN0/RA0), R10.1, R11.2
/Enable*: IC1.6 (CPS1/Vref/C1IN0-/SRI/SCL/SCK/MDMIN/ICSP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), U4.2
GND: C1.2, C2.2, C3.2, C4.2, C5.2, C6.2, C7.2, IC1.8 (VSS), P2.3, P3.2, R11.1, SW1.2, SW2.2, U1.2 (GND), U2.2 (GND), U3.3
unnamed: D1.2 (A), P3.1
unnamed: C2.1, C6.1, D1.1 (K), R10.2, U1.1 (IN), U2.3 (IN)
unnamed: D2.1 (K), R6.1
unnamed: D3.1 (K), R8.1
unnamed: IC1.3 (CLKR/C1IN1-/T1OSO/CLKOUT/OSC2/CPS3/AN3/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), R7.2, R8.2, R9.1, SW2.1
unnamed: IC1.5 (CPS2/C1OUT/SRQ/T0CKI/FLT0/SDA/SDI/INT/M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), R5.2, R6.2, SW1.1
unnamed: IC1.2 (SRNQ/T1CKI/T1OSI/OSC1/CLKIN/RA5), R4.2
unnamed: C1.1, IC1.4 (Vpp/~MCLR/RA3), R2.1, R3.2
unnamed: LED1.2, R9.2
unnamed: P1.1, R1.2
unnamed: P1.2, U4.4
unnamed: P2.1, R4.1
unnamed: C3.1, C5.1, P2.2, U1.3 (OUT)
unnamed: R1.1, U3.1
unnamed: R2.2, U3.4
unnamed: R12.2, U4.1
unnamed: U3.2, U4.3

Notes on the sheet:
+9 Gnd
R1 470Ω R2,R6,R8,R11,R12 1.0KΩ R3 10KΩ R4 220Ω R5,R7 47KΩ R9 270Ω R10 22KΩ D1 SMA 1A C1,C3,C4,C6,C7 0.1uf 0805 C2 33uf C5 220uf P2 3 pin sip pin header IC1 PIV12F1822-I/P 8DIP U1 L7805 DPAK U2 ua78L05 U3,U4 CPC1017N 4DIP SW1,SW2 KXT341 LHS
Rev C1, SOIC 8 footprint changed Rev C, 6V servo power, Continuity check.
Rev A, Added battery voltage sensing and LED connector.
S + -
Trigger + Trigger -
Servo

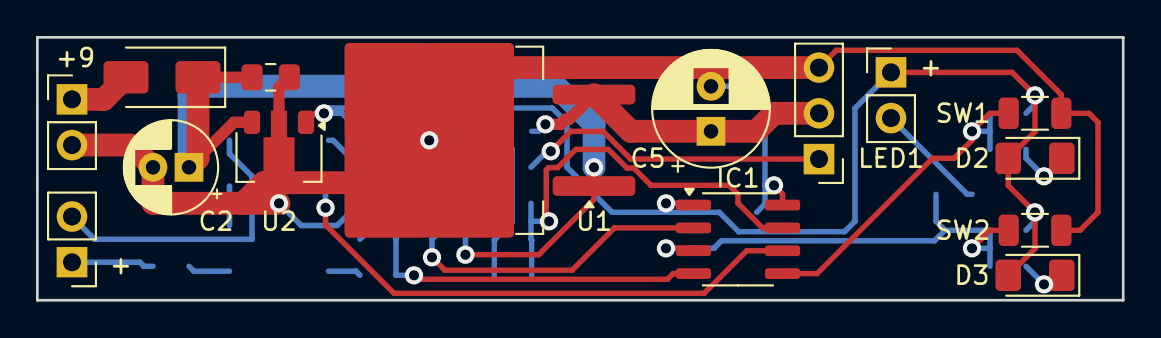
[picture p18: board PCB Rev C/RocketServo.kicad_pcb from above]

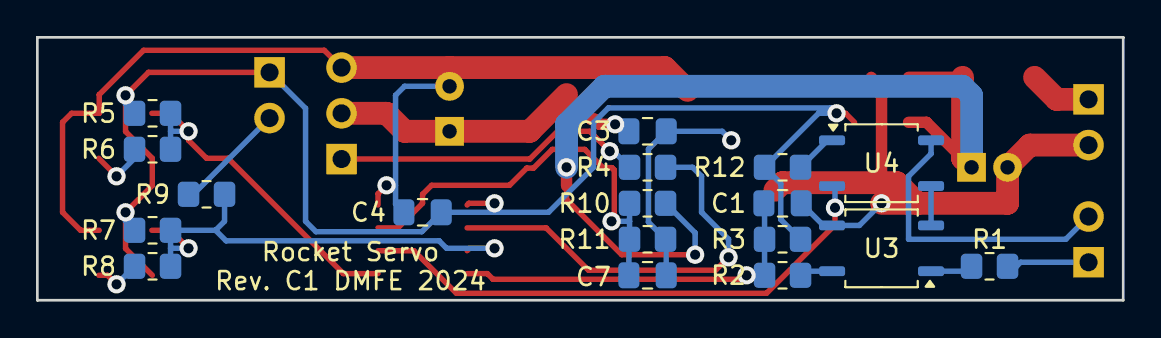
[picture p19: board PCB Rev C/RocketServo.kicad_pcb from below]

Board: 2 copper layers, 60.3 x 14.6 mm, 33 parts (18 on the bottom side), 21 nets.
