DavidMFlynn/Rocket-Servo/(commit log)

2022-09-29 First post
    Waiting for PCB to be made.
    [RCSMCtrl-B_Cu.gbl, RCSMCtrl-B_Mask.gbs, RCSMCtrl-B_Silkscreen.gbo, RCSMCtrl-Edge_Cuts.gm1, RCSMCtrl-F_Cu.gtl, RCSMCtrl-F_Mask.gts, RCSMCtrl-F_Silkscreen.gto, RCSMCtrl-NPTH.drl]
2022-11-09 Rev A PCB just smaller
    [RCSMCtrl-B_Cu.gbl, RCSMCtrl-B_Mask.gbs, RCSMCtrl-B_Silkscreen.gbo, RCSMCtrl-Edge_Cuts.gm1, RCSMCtrl-F_Cu.gtl, RCSMCtrl-F_Mask.gts, RCSMCtrl-F_Silkscreen.gto, RCSMCtrl-NPTH.drl]
2022-12-11 Added LED1 and BattV
    [RocketServo.kicad_pcb, RocketServo.kicad_sch]
2022-12-28 New PCB, blink batt volts
2022-12-28 Added Fab drawings
    [RocketServo.kicad_pcb]
2023-04-24 Added parts list to sch
    [RocketServo.kicad_sch]
2023-12-06 Update to new kicad
    [RocketServo.kicad_pcb]
2024-05-12 R10 to 22K
    [RocketServo.kicad_sch]
2024-05-13 Assy fixture
    [RS_PCBA_Fixture.3mf, RS_PCBA_Fixture.scad, RS_PCBA_Fixture.stl]
2024-09-28 Rev C
    6 volts
    [RocketServo-B_Cu.gbl, RocketServo-B_Mask.gbs, RocketServo-B_Silkscreen.gbo, RocketServo-Edge_Cuts.gm1, RocketServo-F_Cu.gtl, RocketServo-F_Mask.gts, RocketServo-F_Silkscreen.gto, RocketServo-NPTH.drl]
2024-10-15 Rev C
    Active enable of arming, 6V servo power
2024-10-18 Rev C1
    [RocketServo-B_Cu.gbl, RocketServo-B_Mask.gbs, RocketServo-B_Silkscreen.gbo, RocketServo-Edge_Cuts.gm1, RocketServo-F_Cu.gtl, RocketServo-F_Mask.gts, RocketServo-F_Silkscreen.gto, RocketServo-NPTH.drl]
2024-10-31 Rocket Servo 4 PCB
    [RocketServo-B_Cu.gbl, RocketServo-B_Mask.gbs, RocketServo-B_Silkscreen.gbo, RocketServo-Edge_Cuts.gm1, RocketServo-F_Cu.gtl, RocketServo-F_Mask.gts, RocketServo-F_Silkscreen.gto, RocketServo-PTH.drl]
2025-02-17 fixed some text
    [RocketServo.kicad_sch]
2025-02-19 added rotary switch pcb
    [RotarySW.kicad_pcb, RotarySW.kicad_sch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]
2025-02-19 moved stuff
    [RotarySW.kicad_pcb, RotarySW.kicad_sch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]
2026-04-16 Rocket servo 2
    Firmware not done
    [RocketServo.kicad_pcb, RocketServo.kicad_sch]
2026-05-11 Soldering fixture
    [RS2_PCBA_Fixture.3mf, RS2_PCBA_Fixture.stl, RS_PCBA_Fixture.scad]
2026-10-12 Two Channel Rev A
    Fixed power up glitch
2026-10-20 Fixed battery voltage error and flashes
